magnusbpt/Modbus-wireless/Wireless modbus/Billdere/slave front.jpg

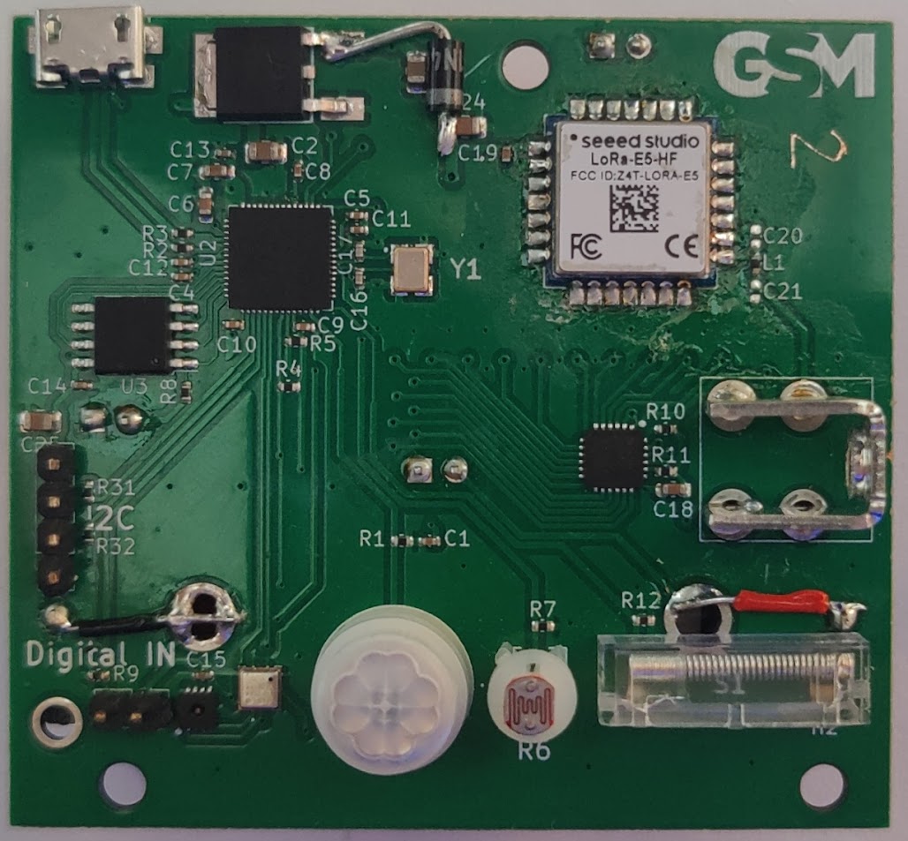
Wireless modbus/Billdere/slave front.jpg
