magnusbpt/Modbus-wireless/Wireless modbus/Billdere/slave back.jpg

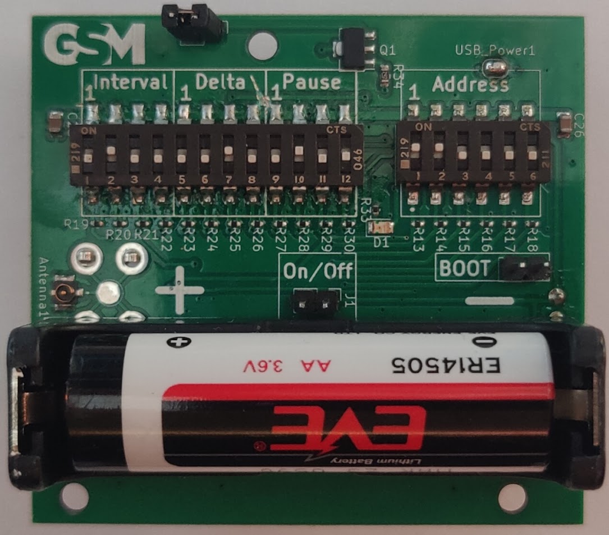
Wireless modbus/Billdere/slave back.jpg
