magnusbpt/Modbus-wireless/Modbus-Master-main/README.md

# GSM-Cloud-Modbus-Master
Repo for working on the GSM Cloud Modbus Master unit.
