magnusbpt/Modbus-wireless/Wireless modbus/Eksamen.pptx

## Lang rækkevidde modbus sensor kommunikation

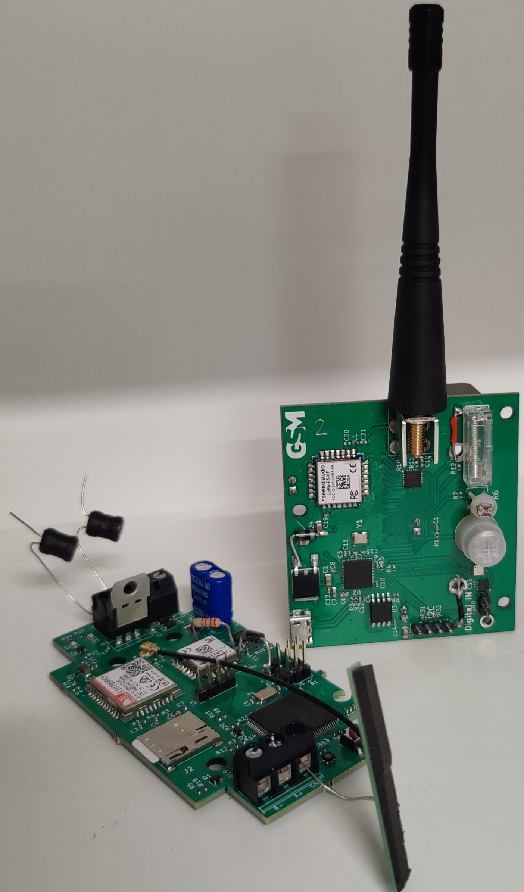
[picture p3: figure]

Afgangsprojekt
Diplomingeniør – Elektronik
Magnus Thurøe & Magnus Tordrup

## Agenda

- Introduktion til projektet
- Test af produkt
- Konklusion af projektet
- Tidsplan

## Introduktion til projektet

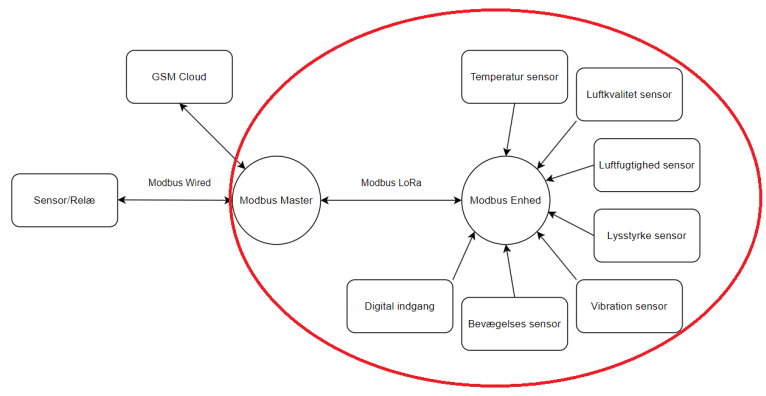
[picture p4: figure]

- GSM teknik ApS
- Forarbejdet
- Trådløs miljøovervågningssystem

## Test af produkt

- Test setup
- Forbindelse mellem enheder
- Eksempel på kommunikation

08600160457946040201000701000100e80201000201d302010003e66e0201000424460201000500000101000600010101000700000157ac

CRC

Slave ID

Adresse 1

Temp data

Data type

Lysstyrke

Luftkvalitet

Digital IN

Bevægelse

Vibration

IMEI nummer

Transaktions ID

Data kommando

Antal Sensore

Luftfugtighed

## Konklusion af projektet

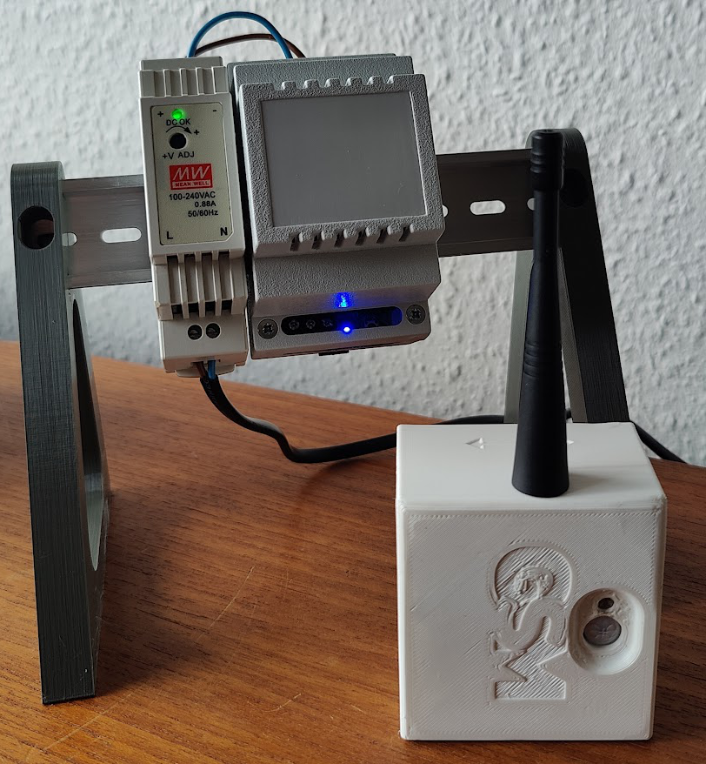
[picture p5: figure]

- Kommunikation
- Sensorer
- Batteri
- EMC

Notes: Kommunikation:
virker 98%, antenne matching
Besked optimering
ID check skal laves om

Senorer:
Vibration = burde laves til Intrup, skal optimeres
LUX = skal kalibreres
AIR = virker ikke, kræver mere tid, men burde virke

Batteri:
Layout ændringer
Laves kode så den faktisk kommer i sleep

EMC:

## Tidsplan

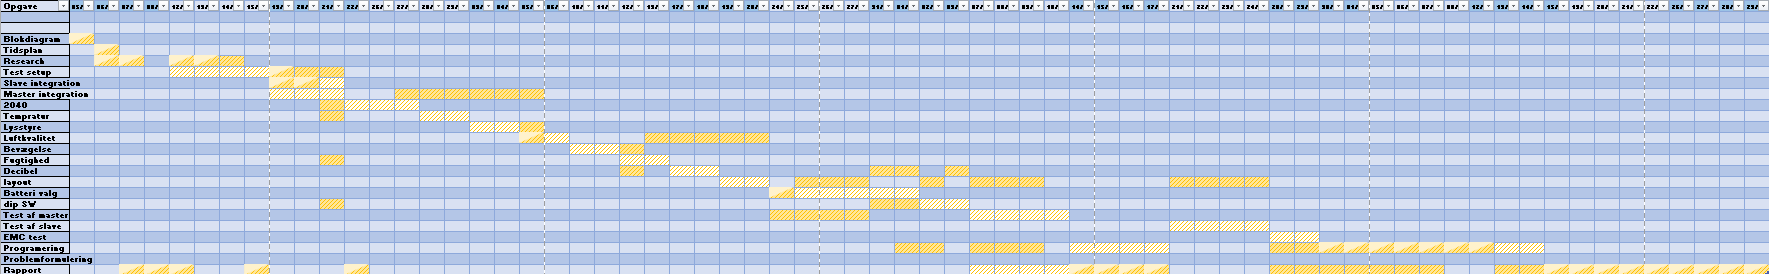
[picture p6: figure]
