magnusbpt/Modbus-wireless/EN 55011 Voltage Mains Class B  (LISN) master 0V.pdf

### EN 55011 Voltage Mains Class B

(LISN)_Test | Passed

# Conducted emission Master 0V

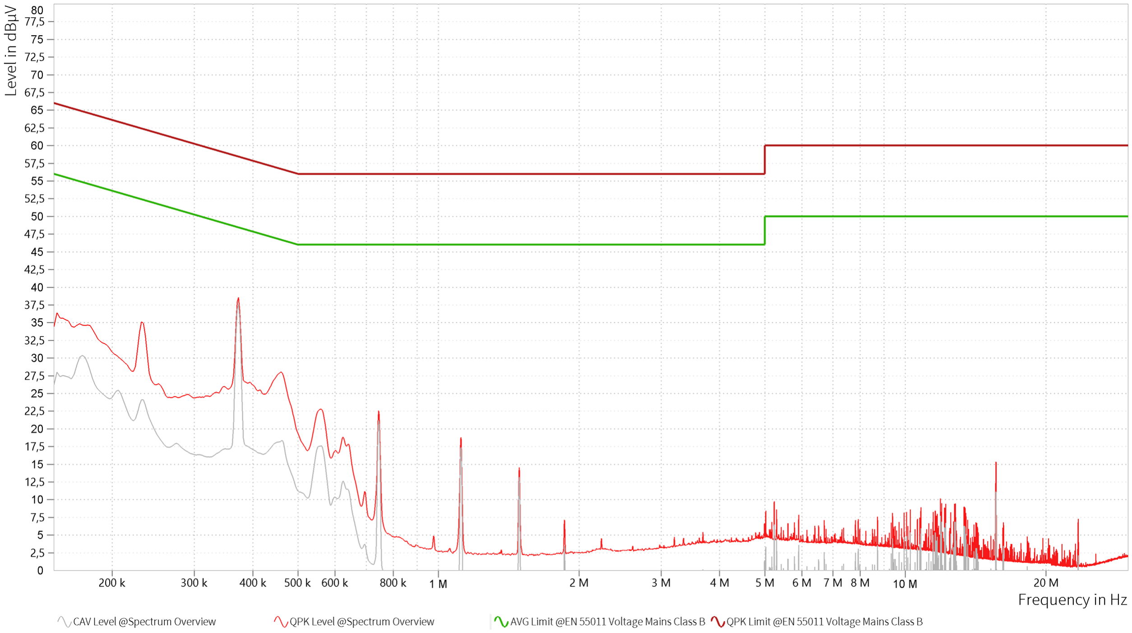
[picture p7: figure]

# EMI Final Results

Frequency; [MHz]; QPK Level [dBµV]; QPK Limit [dBµV]; QPK Margin [dB]; CAV Level [dBµV]; CAV: AVG Limit [dBµV]; CAV Margin [dB]; Correction; Line; Meas. BW [kHz]; Meas. Time [ms]; Time of Meas.; Source; Comment

08-12-2023 / 10:08 | 1 / 1
