magnusbpt/Modbus-wireless/Wireless modbus/Billdere/Adresse_S.png

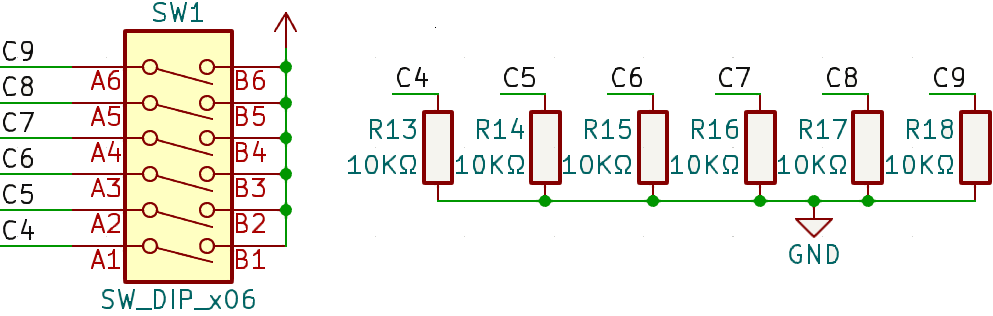
Wireless modbus/Billdere/Adresse_S.png
