magnusbpt/Modbus-wireless/Wireless modbus/Billdere/Air_qua.jpg

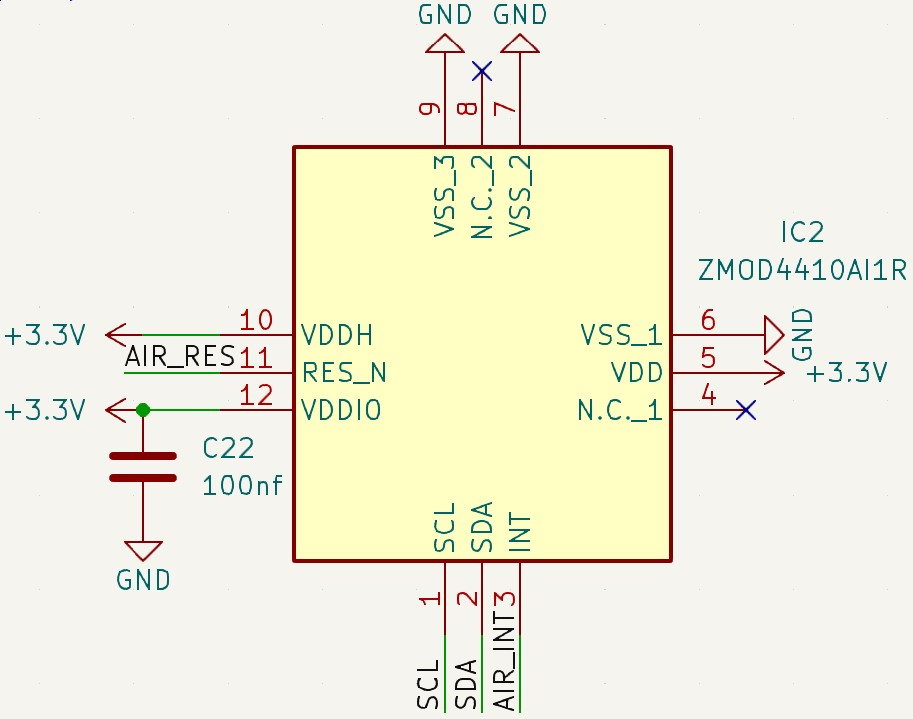
Wireless modbus/Billdere/Air_qua.jpg
