magnusbpt/Modbus-wireless/Wireless modbus/Billdere/Digital_in.jpg

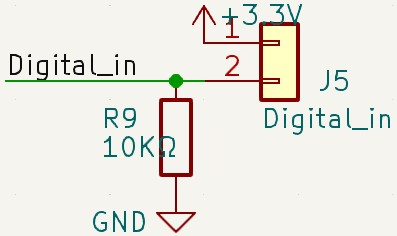
Wireless modbus/Billdere/Digital_in.jpg
