magnusbpt/Modbus-wireless/Wireless modbus/Billdere/Flash.jpg

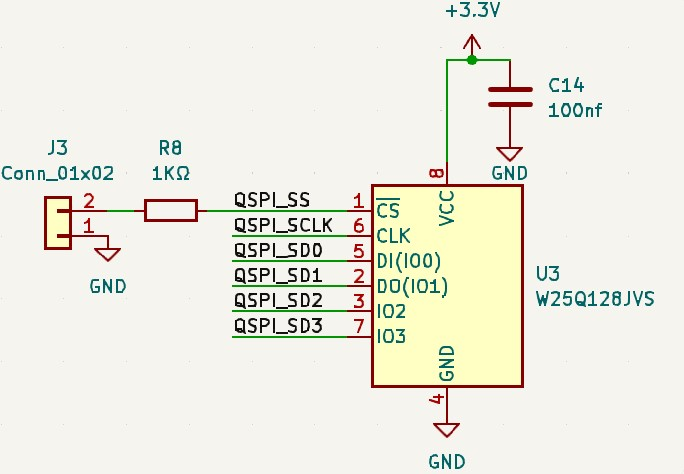
Wireless modbus/Billdere/Flash.jpg
