magnusbpt/Modbus-wireless/Wireless modbus/Billdere/Konfiguration bits.jpg

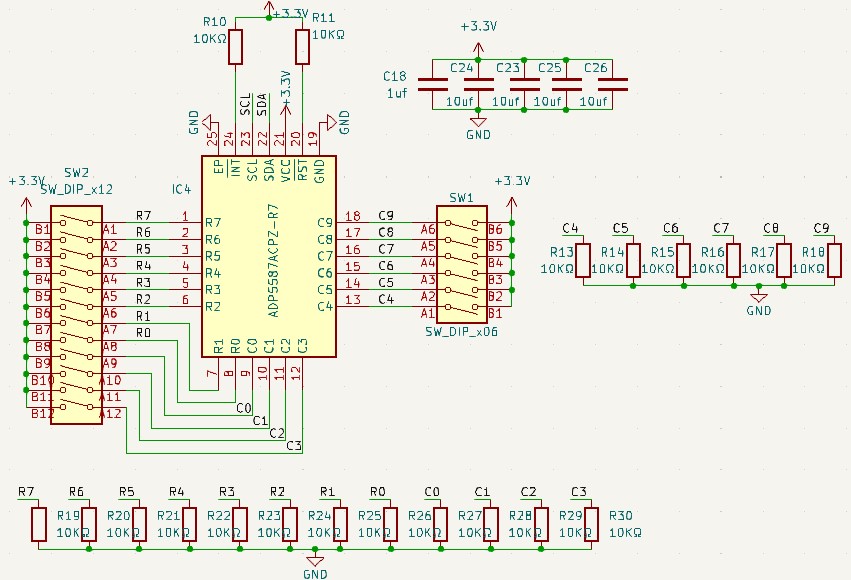
Wireless modbus/Billdere/Konfiguration bits.jpg
