magnusbpt/Modbus-wireless/Wireless modbus/Billdere/LUX.jpg

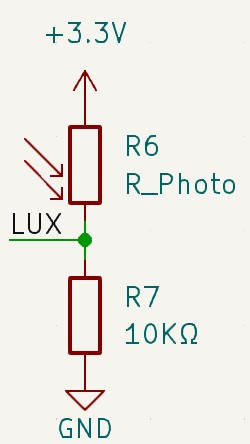
Wireless modbus/Billdere/LUX.jpg
