magnusbpt/Modbus-wireless/Wireless modbus/Billdere/PIR.jpg

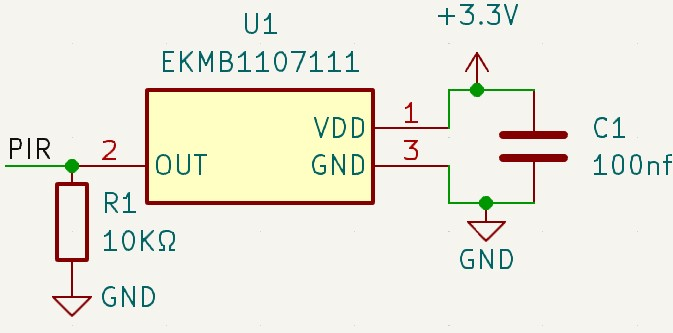
Wireless modbus/Billdere/PIR.jpg
