magnusbpt/Modbus-wireless/Wireless modbus/Billdere/Power.jpg

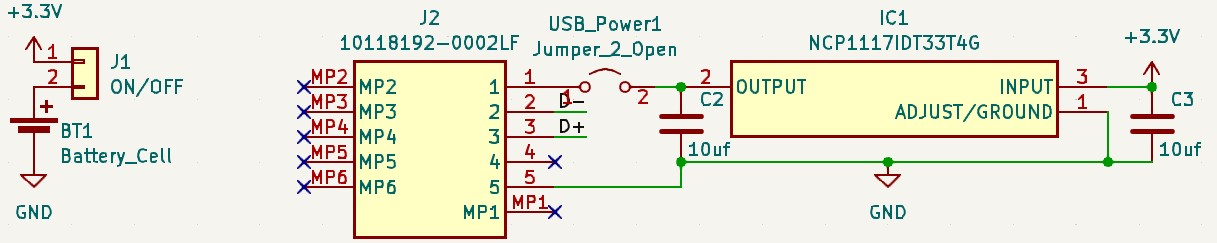
Wireless modbus/Billdere/Power.jpg
