magnusbpt/Modbus-wireless/Wireless modbus/Billdere/RP2040.jpg

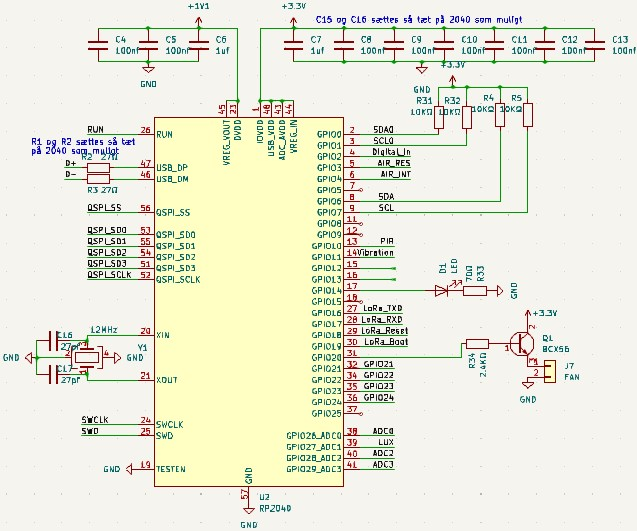
Wireless modbus/Billdere/RP2040.jpg
