magnusbpt/Modbus-wireless/Wireless modbus/Billdere/schematik slave.jpg

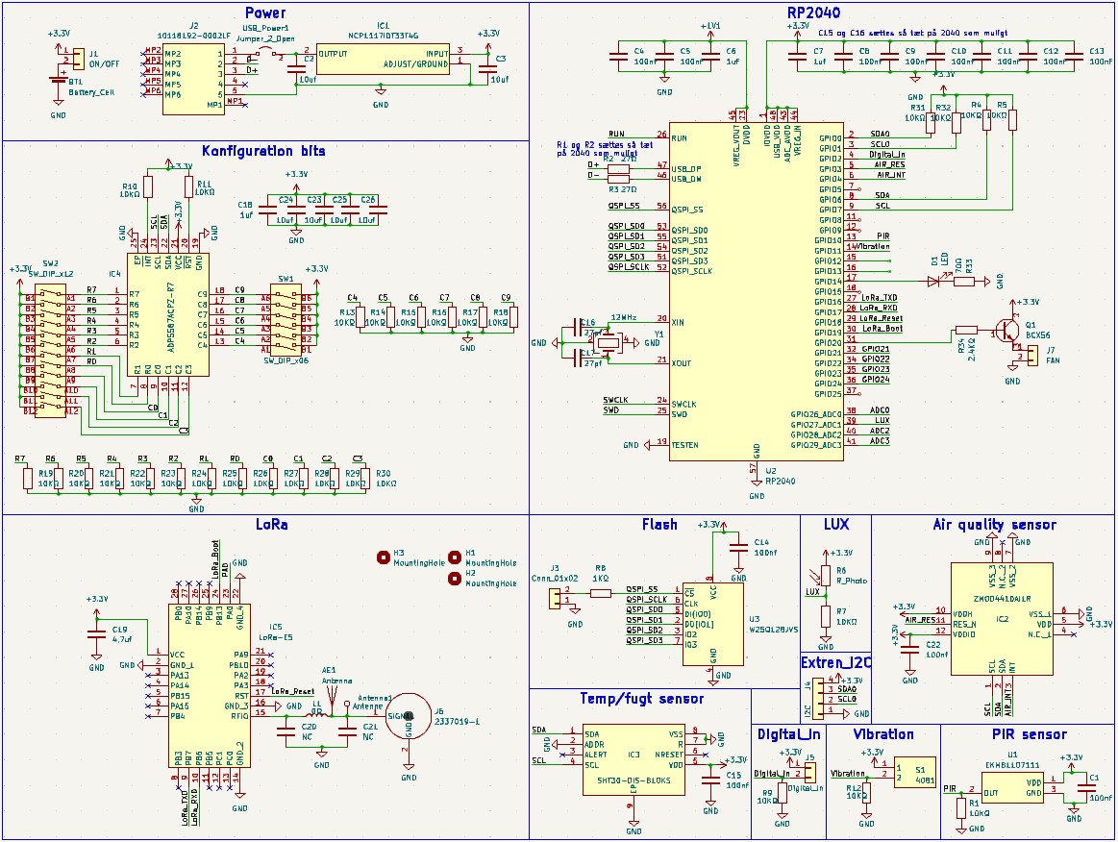
Wireless modbus/Billdere/schematik slave.jpg
