magnusbpt/Modbus-wireless/Wireless modbus/Billdere/Slave 3D back.jpg

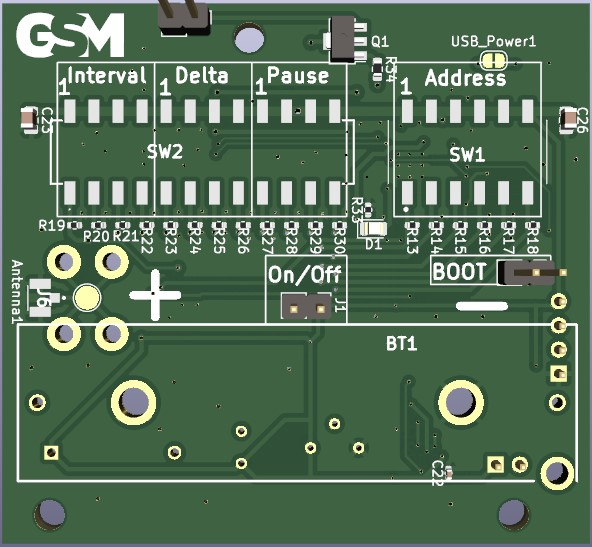
Wireless modbus/Billdere/Slave 3D back.jpg
