magnusbpt/Modbus-wireless/Wireless modbus/Billdere/Slave 3D front.jpg

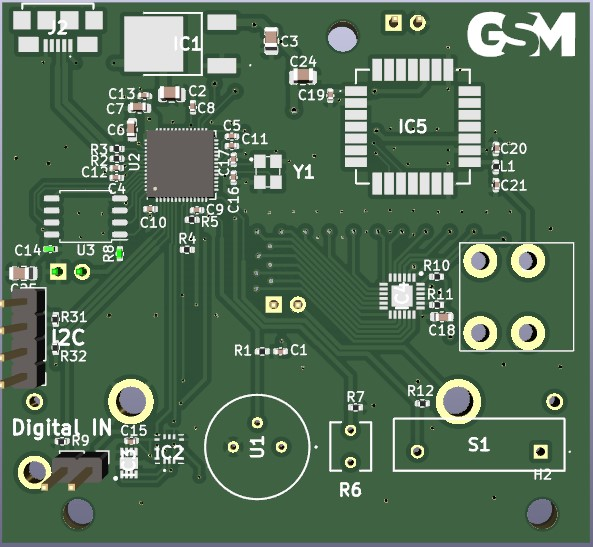
Wireless modbus/Billdere/Slave 3D front.jpg
