magnusbpt/Modbus-wireless/Wireless modbus/Billdere/Temp.jpg

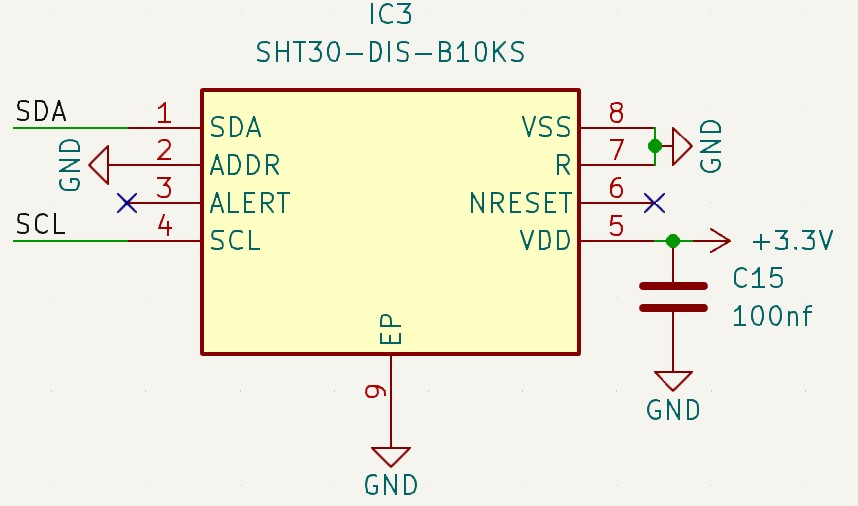
Wireless modbus/Billdere/Temp.jpg
