magnusbpt/Modbus-wireless/Wireless modbus/Billdere/Vibration.jpg

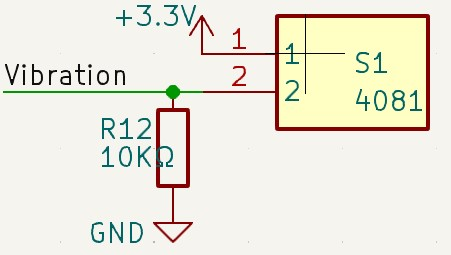
Wireless modbus/Billdere/Vibration.jpg
