magnusbpt/Modbus-wireless/Wireless modbus/Produktion/JLC doc/Modbus master BOM JLC.xlsx

Comment | Designator | Footprint | JLCPCB Part #
33pF | C1-5 | Capacitor_SMD:C_0402_1005Metric | C526997
100nF | C6-9, C11, C12, C14 | Capacitor_SMD:C_0402_1005Metric | C56392
330nF | C10 | Capacitor_SMD:C_0805_2012Metric | C161258
1uF | C15 | Capacitor_SMD:C_0402_1005Metric | C326568
100uF | C16 | Capacitor_SMD:C_1206_3216Metric | C76661
4.7uF | C17 | Capacitor_SMD:C_0402_1005Metric | C2858031
ESDA6V1-5W6 | D1 | SELF_MADE:SOT323-6L | C87908
NH-B2020RGBA-HF | D2 | NHB2020RGBAHF | C2874116
GREEN LED | D3 | LED_SMD:LED_0603_1608Metric | C965805
SS0540_R1_00001 | D4, D5, D8 | Diode_SMD:D_SOD-123 | C282388
GS1M-LTP | D6 | Diode_SMD:D_SMA | C435833
YELLOW LED | D7 | LED_SMD:LED_0603_1608Metric | C965802
DF2S6.8FS,L3M | D9 | Diode_SMD:D_SOD-923 | C1972978
SIM8066-6-1-14-01-A | J2 | SIM8066611401A:SIM8066611401A | C381071
Conn_Coaxial | J4 | Connector_Coaxial:U.FL_Hirose_U.FL-R-SMT-1_Vertical | C434808
0R | L1 | Resistor_SMD:R_0402_1005Metric | C881335
BC847CW | Q1, Q2 | Package_TO_SOT_SMD:SOT-323_SC-70 | C75567
10K | R1, R5-9, R11-14, R18, R19, R21, R26, R27, R29, R30 | Resistor_SMD:R_0402_1005Metric | C25744
22 | R2-4 | Resistor_SMD:R_0402_1005Metric | C25092
47k | R10 | Resistor_SMD:R_0402_1005Metric | C25792
680 | R15 | Resistor_SMD:R_0402_1005Metric | C25113
910 | R16, R17 | Resistor_SMD:R_0402_1005Metric | C44933
20K | R20 | Resistor_SMD:R_0402_1005Metric | C25765
1K | R22, R23, R25 | Resistor_SMD:R_0402_1005Metric | C11702
62 | R24 | Resistor_SMD:R_0805_2012Metric | C560547
200K | R28 | Resistor_SMD:R_0402_1005Metric | C25764
TL3305AF260QG | SW1 | SELF_MADE:TL3305AF260QG | C2886902
ATmega2560-16A | U1 | Package_QFP:TQFP-100_14x14mm_P0.5mm | C22460
SP485EN-L/TR | U2 | Package_SO:SOIC-8_3.9x4.9mm_P1.27mm | C6855
SIM7080G | U4 | SIM7080G:XCVR_SIM7080G | C2943992
LSF0204PW-Q100J | U5 | Package_SO:TSSOP-14_4.4x5mm_P0.65mm | C202288
ABM3B-8.000MHZ-10-1-U-T | Y1 | SELF_MADE:Oscillator_SMD_abm3b | C276420
