magnusbpt/Modbus-wireless/Wireless modbus/Wireless slave/wireless_Slave/JLC/JLCPCB_BOM.xls

Comment | Designator | Footprint | JLCPCB Part#(optional)
C1, C4, C5, C8-15, C22 | 100nf | Capacitor_SMD:C_0402_1005Metric | C1525
C2, C3, C23-26 | 10uf | Capacitor_SMD:C_0805_2012Metric | C15850
C6, C7, C18 | 1uf | Capacitor_SMD:C_0603_1608Metric | C1592
C16, C17 | 27pf | Capacitor_SMD:C_0402_1005Metric | C1557
C19 | 4,7uf | Capacitor_SMD:C_0402_1005Metric | C368809
D1 | LED | LED_SMD:LED_0805_2012Metric | C598370
IC1 | NCP1117IDT33T4G | NCP1117IDT33T4G | C2902115
IC2 | ZMOD4410AI1R | ZMOD4410AI1R | C5342493
IC3 | SHT30-DIS-B10KS | SON50P250X250X100-9N-D | C2687423
IC4 | ADP5587ACPZ-R7 | QFN50P400X400X80-25N-D | C579262
J2 | 10118192-0002LF | 101181920002LF | C2972784
J6 | 2337019-1 | 23370191 | C434807
L1 | 0Ω | Resistor_SMD:R_0402_1005Metric | C881335
Q1 | BCX56 | Package_TO_SOT_SMD:SOT-89-3 | C5345980
R1, R4, R5, R7, R9-32 | 10KΩ | Resistor_SMD:R_0402_1005Metric | C25744
R2, R3 | 27Ω | Resistor_SMD:R_0402_1005Metric | C25100
R8 | 1KΩ | Resistor_SMD:R_0402_1005Metric | C11702
R33 | 70Ω | Resistor_SMD:R_0402_1005Metric | C25133
R34 | 2.4KΩ | Resistor_SMD:R_0603_1608Metric | C22940
SW1 | SW_DIP_x06 | SamacSys_Parts3:2196LPST | C2842671
SW2 | SW_DIP_x12 | SamacSys_Parts3:21912LPST
U2 | RP2040 | Package_DFN_QFN:QFN-56-1EP_7x7mm_P0.4mm_EP3.2x3.2mm | C2040
U3 | W25Q128JVS | Package_SO:SOIC-8_5.23x5.23mm_P1.27mm | C97521
Y1 | 12MHz | SamacSys_Parts2:X322512MSB4SI | C9002
