magnusbpt/Modbus-wireless/Wireless modbus/Wireless slave/3D/bund.stl

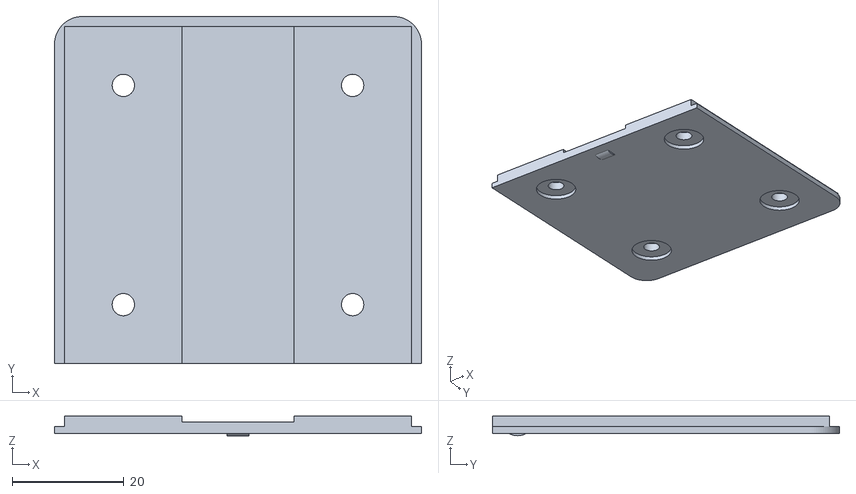
[picture p22: CAD file, 2024-01-15]
Wireless modbus/Wireless slave/3D/bund.stl
65.8 x 62.2 x 3.50
