magnusbpt/Modbus-wireless/Wireless modbus/Wireless slave/3D/slave.stl

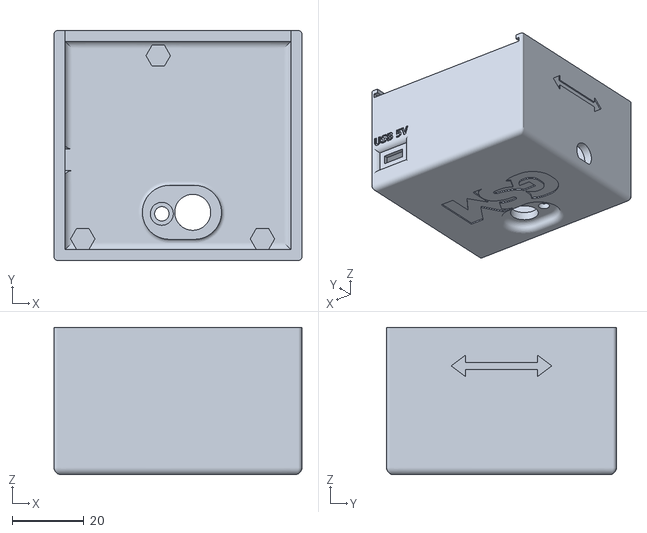
[picture p23: CAD file, 2024-01-15]
Wireless modbus/Wireless slave/3D/slave.stl
69.0 x 64.0 x 41.0
