magnusbpt/Modbus-wireless/(list of files, cad)

Other CAD files:
Wireless modbus/Wireless slave/3D/OldVersions/TOP.0001.ipt
Wireless modbus/Wireless slave/3D/OldVersions/bund.0003.ipt
Wireless modbus/Wireless slave/3D/OldVersions/slave.0003.ipt
Wireless modbus/Wireless slave/3D/SlaveLåg.ipt
Wireless modbus/Wireless slave/3D/TOP.ipt
Wireless modbus/Wireless slave/3D/bund.ipt
Wireless modbus/Wireless slave/3D/slave.ipt
Wireless modbus/Wireless slave/3D/slave2.ipt
