magnusbpt/Modbus-wireless/Modbus-Master-main/Sim7080_test_CAT/Sim7080_test_CAT.txt

=~=~=~=~=~=~=~=~=~=~=~= PuTTY log 2023.02.27 09:12:14 =~=~=~=~=~=~=~=~=~=~=~=
D

+CPIN: NOT READY

OK
AT+CGDCONT=1,"IP","iot.1nce.net"

OK
AT+CFUN=1

OK

+CPIN: READY

SMS Ready

OK
AT+CFUN=0

+CPIN: NOT READY

OK
AT+CGDCONT=1,"IP","iot.1nce.net"

OK
AT+CFUN=1

OK

+CPIN: READY

SMS Ready
Detected: OK
Detected: OK
Detected: OK
Detected: OK
Detected: OK
AT+CMNB=1

OK
-----------------------------Log nr: 1  9:12:10  27.2.2023-----------------------------
Detected: +CEREG: 0,5
-----------------------------time: 9:12:11  27.2.2023-----------------------------
AT+CPIN?

+CPIN: READY

OK
AT+CSQ

+CSQ: 30,99

OK
AT+CFUN=0

+CPIN: NOT READY

OK
AT+CGDCONT=1,"IP","iot.1nce.net"

OK
AT+CFUN=1

OK

+CPIN: READY

SMS Ready
AT+COPS?

+COPS: 0,0,"TeliaDk",7

OK
AT+CGNAPN

+CGNAPN: 1,"iot.1nce.net"

OK
AT+CGATT?

+CGATT: 1

OK
AT+CNACT=0,1

OK

+APP PDP: 0,ACTIVE
AT+CNACT?

+CNACT: 0,1,"10.173.199.220"
+CNACT: 1,0,"0.0.0.0"AT+CAOPEN=0,0,"UDP","164.92.139.57",8080

+CAOPEN: 0,0

OK
AT+CASEND=0,2

> 
OK

+CADATAIND: 0

+CAURC: buffer full,0
AT+CAACK=0

+CAACK: 2,0

OK
AT+CARECV=0,2

+CARECV: 2,00

OK
AT+CACLOSE=0

OK
AT+CNACT=0,0

OK

+APP PDP: 0,DEACTIVE
AT+CPOWD=1

NORMAL POWER DOWN
Detected: OK
Detected: OK
AT+CMNB=1

OK
-----------------------------Log nr: 2  9:20:7  27.2.2023-----------------------------
Detected: +CEREG: 0,5
-----------------------------time: 9:20:7  27.2.2023-----------------------------
AT+CPIN?

+CPIN: READY

OK
AT+CSQ

+CSQ: 23,99

OK
AT+CFUN=0

+CPIN: NOT READY

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
AT+CPIN?

+CPIN: READY

OK
AT+CSQ

+CSQ: 23,99

OK
AT+CFUN=0

+CPIN: NOT READY

OK
AT+CGDCONT=1,"IP","iot.1nce.net"

OK
AT+CFUN=1

OK

+CPIN: READY

SMS Ready
AT+COPS?

+COPS: 0,0,"TeliaDk",7

OK
AT+CGNAPN

+CGNAPN: 1,"iot.1nce.net"

OK
AT+CGATT?

+CGATT: 1

OK
AT+CNACT=0,1

OK

+APP PDP: 0,ACTIVE
AT+CNACT?

+CNACT: 0,1,"10.173.199.220"
+CNACT: 1,0,"0.0.0.0"AT+CAOPEN=0,0,"UDP","164.92.139.57",8080

+CAOPEN: 0,0

OK
AT+CASEND=0,2

> 
OK

+CADATAIND: 0

+CAURC: buffer full,0
AT+CAACK=0

+CAACK: 2,0

OK
AT+CARECV=0,2

+CARECV: 2,00

OK
AT+CACLOSE=0

OK
AT+CNACT=0,0

OK

+APP PDP: 0,DEACTIVE
AT+CPOWD=1
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
