magnusbpt/Modbus-wireless/Radiated Emission test workbenh farraday cage Modbus Master.pdf

### Radiated Emission test workbenh farraday

cage Modbus Master | Failed

# EMI Test Report

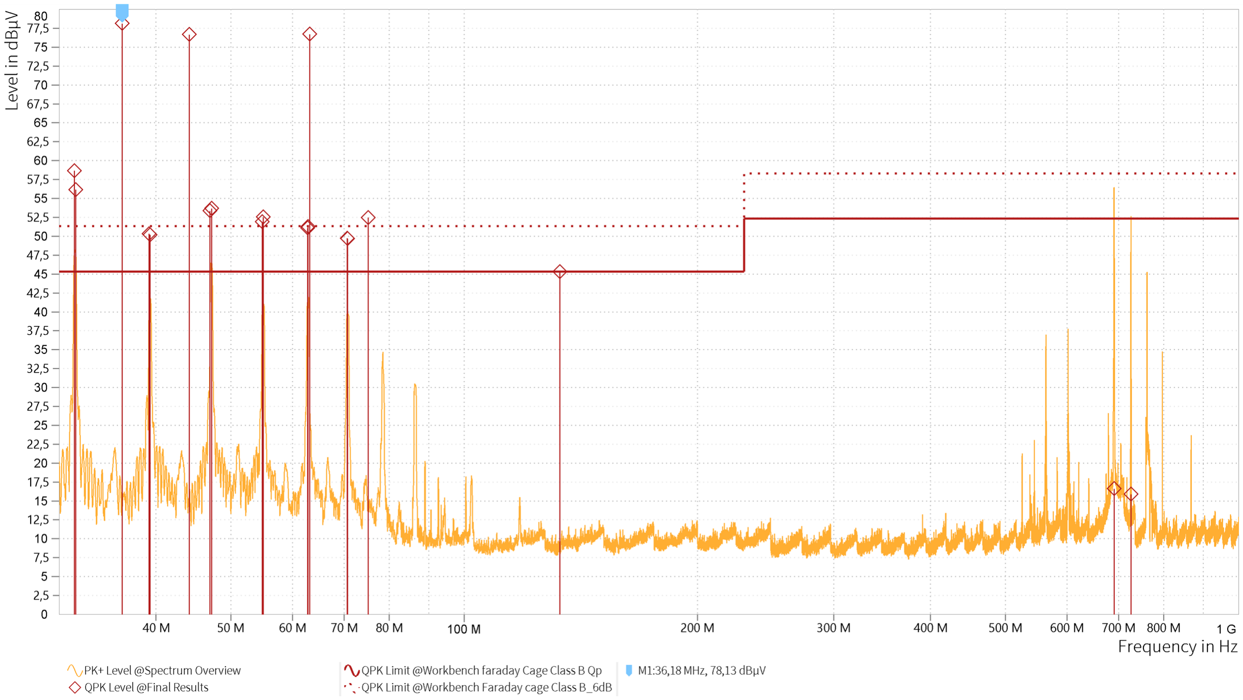
[picture p24: figure]

04-12-2023 / 09:41 | 1 / 3

cage Modbus Master | Failed

# EMI Final Results

Rg | Frequency [MHz] | QPK Level [dBµV] | QPK Limit [dBµV] | QPK Margin [dB] | Correction [dB] | Meas. BW [kHz] | Meas. Time [ms] | Time of Meas. | Source | Comment
1 | 31,380 | 58,67 | 45,30 | -13,37 | 0,00 | 120,000 | 100,000 | 09:28:53 | Critical Points
1 | 31,500 | 56,16 | 45,30 | -10,86 | 0,00 | 120,000 | 100,000 | 09:31:42 | Critical Points
1 | 36,180 | 78,13 | 45,30 | -32,83 | 0,00 | 120,000 | 100,000 | 10:30:02 | Critical Points
1 | 39,180 | 50,32 | 45,30 | -5,02 | 0,00 | 120,000 | 100,000 | 09:28:55 | Critical Points
1 | 39,300 | 50,19 | 45,30 | -4,89 | 0,00 | 120,000 | 100,000 | 09:31:44 | Critical Points
1 | 44,160 | 76,67 | 45,30 | -31,37 | 0,00 | 120,000 | 100,000 | 10:30:05 | Critical Points
1 | 46,980 | 53,36 | 45,30 | -8,06 | 0,00 | 120,000 | 100,000 | 09:28:56 | Critical Points
1 | 47,190 | 53,66 | 45,30 | -8,36 | 0,00 | 120,000 | 100,000 | 09:31:46 | Critical Points
1 | 54,870 | 51,91 | 45,30 | -6,61 | 0,00 | 120,000 | 100,000 | 09:28:58 | Critical Points
1 | 55,050 | 52,54 | 45,30 | -7,24 | 0,00 | 120,000 | 100,000 | 09:31:47 | Critical Points
1 | 62,790 | 51,08 | 45,30 | -5,78 | 0,00 | 120,000 | 100,000 | 09:29:00 | Critical Points
1 | 62,820 | 51,28 | 45,30 | -5,98 | 0,00 | 120,000 | 100,000 | 09:31:49 | Critical Points
1 | 63,180 | 76,70 | 45,30 | -31,40 | 0,00 | 120,000 | 100,000 | 10:30:06 | Critical Points
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
1 | 690,270 | 16,60 | 52,30 | 35,70 | 0,00 | 120,000 | 100,000 | 09:31:53 | Critical Points
1 | 725,790 | 15,89 | 52,30 | 36,41 | 0,00 | 120,000 | 100,000 | 09:31:55 | Critical Points

# Test Information

### Description Test Standard Test Site Operator Name
