magnusbpt/Modbus-wireless/workbench faraday cage 10khz-1ghz_Test Modbus master original conf..pdf

### Workbench faraday cage_Test (1) (2)

(restored) (2) | Inconclusive

# Test Report

### Spectrum Overview

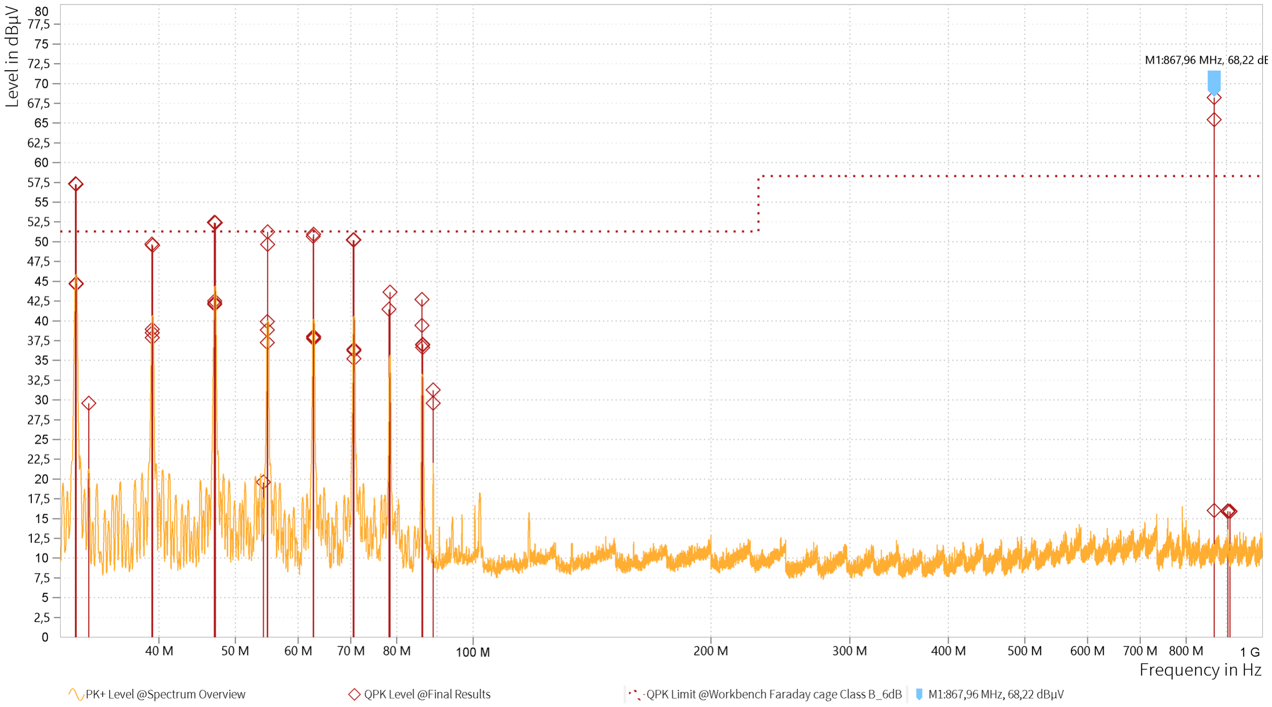
[picture p25: figure]

# EMI Final Results

Rg | Frequency [MHz] | QPK Level [dBµV] | Correction [dB] | Meas. BW [kHz] | Meas. Time [ms] | Time of Meas. | Source | Comment
1 | 31,350 | 57,30 | 0,00 | 120,000 | 100,000 | 10:27:59 | Critical Points
1 | 31,410 | 44,63 | 0,00 | 120,000 | 100,000 | 10:14:30 | Critical Points
1 | 31,410 | 44,71 | 0,00 | 120,000 | 100,000 | 10:17:13 | Critical Points
1 | 31,410 | 44,68 | 0,00 | 120,000 | 100,000 | 10:17:44 | Critical Points
1 | 31,410 | 57,25 | 0,00 | 120,000 | 100,000 | 10:29:01 | Critical Points
1 | 32,580 | 29,57 | 0,00 | 120,000 | 100,000 | 10:29:02 | Critical Points
1 | 39,180 | 49,67 | 0,00 | 120,000 | 100,000 | 10:28:01 | Critical Points
1 | 39,240 | 38,45 | 0,00 | 120,000 | 100,000 | 10:14:32 | Critical Points
1 | 39,240 | 37,87 | 0,00 | 120,000 | 100,000 | 10:17:16 | Critical Points
1 | 39,240 | 38,89 | 0,00 | 120,000 | 100,000 | 10:17:47 | Critical Points
1 | 39,270 | 49,52 | 0,00 | 120,000 | 100,000 | 10:29:04 | Critical Points
1 | 47,010 | 52,42 | 0,00 | 120,000 | 100,000 | 10:28:03 | Critical Points
1 | 47,070 | 42,26 | 0,00 | 120,000 | 100,000 | 10:14:33 | Critical Points
1 | 47,070 | 42,08 | 0,00 | 120,000 | 100,000 | 10:17:18 | Critical Points
1 | 47,070 | 42,49 | 0,00 | 120,000 | 100,000 | 10:17:49 | Critical Points
1 | 47,130 | 52,38 | 0,00 | 120,000 | 100,000 | 10:29:06 | Critical Points
1 | 54,270 | 19,57 | 0,00 | 120,000 | 100,000 | 10:28:05 | Critical Points
04-12-2023 / 10:31 | 1 / 2

### Workbench faraday cage_Test (1) (2)

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
1 | 908,790 | 15,88 | 0,00 | 120,000 | 100,000 | 10:17:31 | Critical Points
1 | 908,790 | 15,90 | 0,00 | 120,000 | 100,000 | 10:18:02 | Critical Points

# Test Information

### Description Test Standard Test Site Operator Name

04-12-2023 / 10:31 | 2 / 2
