magnusbpt/Modbus-wireless/workbench faraday cage 10khz-1ghz_Test Modbus master with 2x1mH in series wih supply.pdf

workbench faraday cage 10khz-1ghz_Test | Inconclusive

# Test Report

### Spectrum Overview

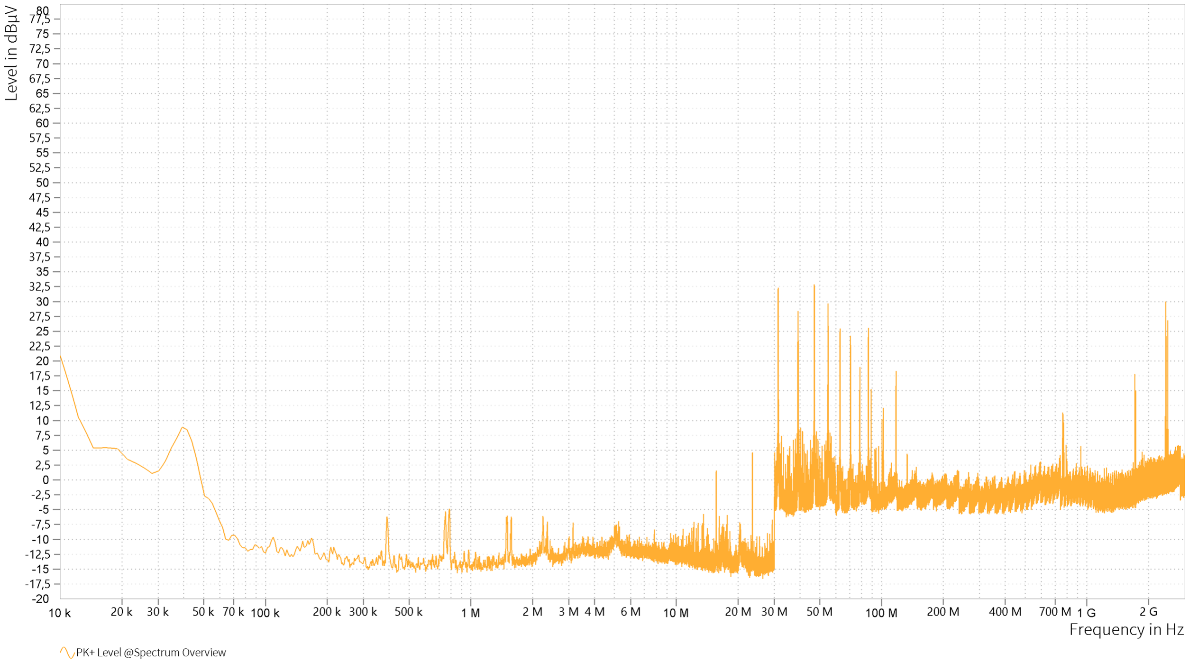
[picture p26: figure]

# EMI Final Results

Rg | Frequency [MHz] | QPK Level [dBµV] | Correction [dB] | Meas. BW [kHz] | Meas. Time [ms] | Time of Meas. | Source | Comment
1 | 0,010 | 68,41 | 0,00 | 9,000 | 100,000 | 09:48:19 | Critical Points
1 | 0,010 | 69,50 | 0,00 | 9,000 | 100,000 | 09:52:57 | Critical Points
1 | 0,010 | 30,44 | 0,00 | 9,000 | 100,000 | 10:01:54 | Critical Points
1 | 0,010 | 29,86 | 0,00 | 9,000 | 100,000 | 10:05:55 | Critical Points
1 | 0,010 | 30,58 | 0,00 | 9,000 | 100,000 | 10:12:15 | Critical Points
1 | 0,017 | 72,70 | 0,00 | 9,000 | 100,000 | 09:53:00 | Critical Points
1 | 0,017 | 16,04 | 0,00 | 9,000 | 100,000 | 10:01:56 | Critical Points
1 | 0,017 | 19,35 | 0,00 | 9,000 | 100,000 | 10:12:17 | Critical Points
1 | 0,019 | 66,72 | 0,00 | 9,000 | 100,000 | 09:48:22 | Critical Points
1 | 0,019 | 17,56 | 0,00 | 9,000 | 100,000 | 10:05:57 | Critical Points
1 | 0,037 | 70,80 | 0,00 | 9,000 | 100,000 | 09:48:25 | Critical Points
1 | 0,037 | 69,45 | 0,00 | 9,000 | 100,000 | 09:53:02 | Critical Points
1 | 0,039 | 17,25 | 0,00 | 9,000 | 100,000 | 10:01:58 | Critical Points
1 | 0,039 | 16,04 | 0,00 | 9,000 | 100,000 | 10:12:19 | Critical Points
1 | 0,042 | 20,34 | 0,00 | 9,000 | 100,000 | 10:05:59 | Critical Points
1 | 0,051 | 56,76 | 0,00 | 9,000 | 100,000 | 09:48:27 | Critical Points
1 | 0,053 | 54,62 | 0,00 | 9,000 | 100,000 | 09:53:03 | Critical Points
04-12-2023 / 10:13 | 1 / 4

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
1 | 2.426,003 | 24,11 | 0,00 | 9,000 | 100,000 | 10:12:48 | Critical Points
1 | 2.426,052 | 26,75 | 0,00 | 9,000 | 100,000 | 10:12:50 | Critical Points
1 | 2.479,917 | 24,45 | 0,00 | 9,000 | 100,000 | 10:12:52 | Critical Points
1 | 2.479,994 | 23,81 | 0,00 | 9,000 | 100,000 | 10:12:54 | Critical Points

# [No Generic Table(s) Selected]

# Test Information

### Description Test Standard Test Site Operator Name
