magnusbpt/Modbus-wireless/workbench faraday cage 10khz-1ghz_Test Modbus slave test original conf. Lora gnd.pdf

Workbench faraday cage_Test (3) (2) | Inconclusive

# Test Report

### Spectrum Overview

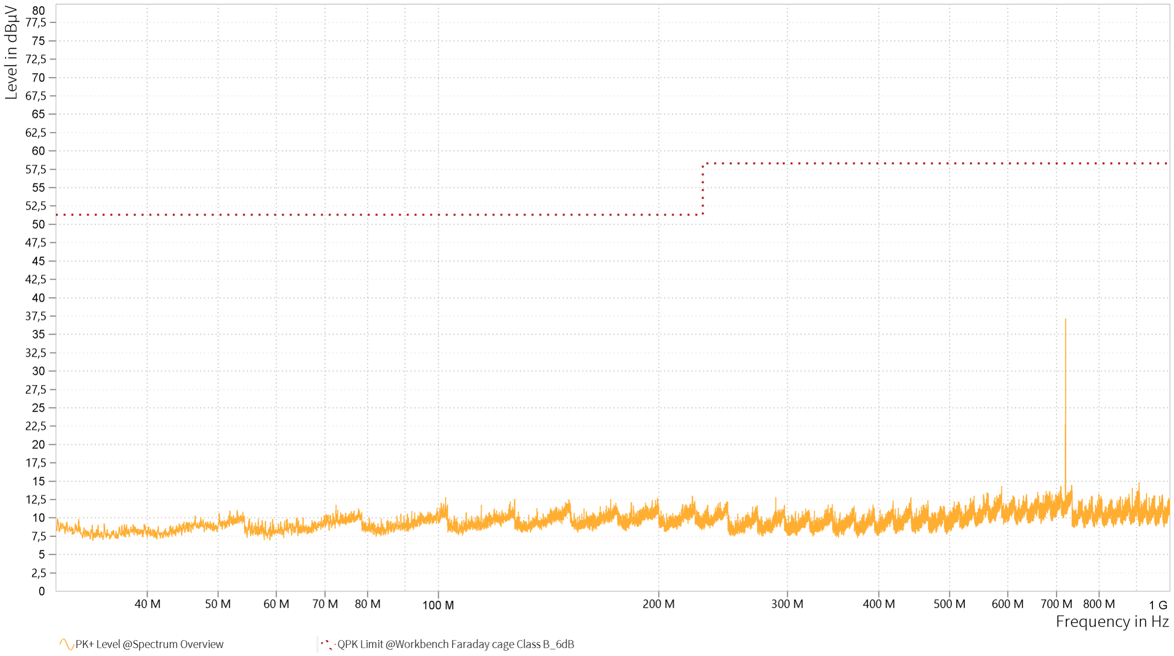
[picture p27: figure]

# EMI Final Results

Rg | Frequency [MHz] | QPK Level [dBµV] | Correction [dB] | Meas. BW [kHz] | Meas. Time [ms] | Time of Meas. | Source | Comment
1 | 38,790 | 33,15 | 0,00 | 120,000 | 100,000 | 10:52:11 | Critical Points
1 | 69,570 | 33,76 | 0,00 | 120,000 | 100,000 | 10:52:13 | Critical Points
1 | 72,630 | 31,12 | 0,00 | 120,000 | 100,000 | 10:52:14 | Critical Points
1 | 77,910 | 28,53 | 0,00 | 120,000 | 100,000 | 10:52:16 | Critical Points
1 | 96,600 | 24,60 | 0,00 | 120,000 | 100,000 | 10:52:17 | Critical Points
1 | 168,000 | 27,96 | 0,00 | 120,000 | 100,000 | 10:52:19 | Critical Points
1 | 661,170 | 23,49 | 0,00 | 120,000 | 100,000 | 10:52:21 | Critical Points
1 | 720,120 | 20,86 | 0,00 | 120,000 | 100,000 | 10:55:32 | Critical Points
1 | 760,620 | 23,60 | 0,00 | 120,000 | 100,000 | 10:52:22 | Critical Points
1 | 791,370 | 26,73 | 0,00 | 120,000 | 100,000 | 10:52:24 | Critical Points
1 | 867,960 | 16,03 | 0,00 | 120,000 | 100,000 | 10:52:26 | Critical Points
1 | 907,770 | 15,87 | 0,00 | 120,000 | 100,000 | 10:55:34 | Critical Points
04-12-2023 / 10:57 | 1 / 1
