magnusbpt/Modbus-wireless/Workbench faraday cage_Test Master 1mH modbus side.pdf

Workbench faraday cage_Test (4) (3) | Inconclusive

# Master modbus side 1mH coils

### Spectrum Overview

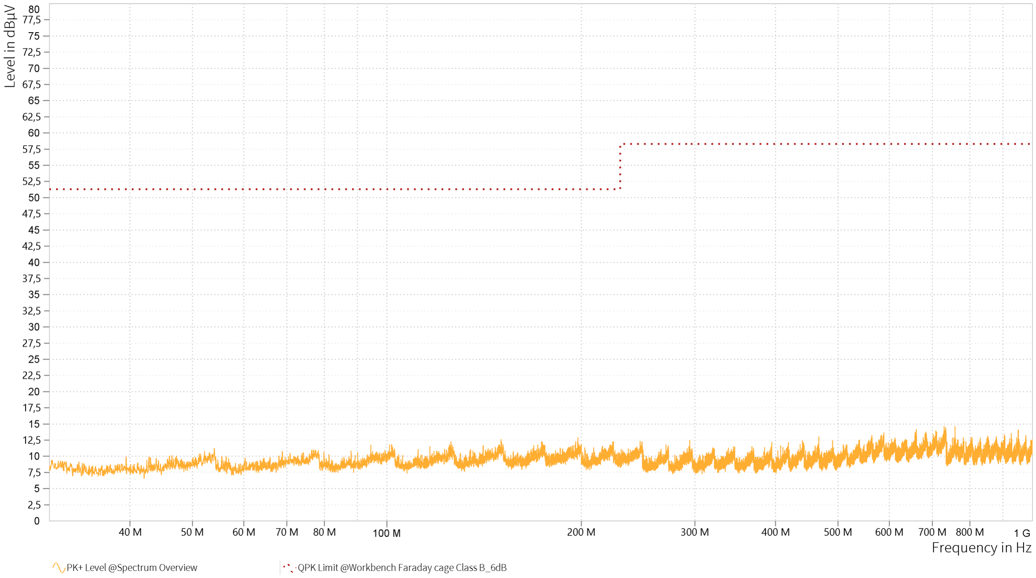
[picture p28: figure]

# EMI Final Results

Rg | Frequency [MHz] | QPK Level [dBµV] | Correction [dB] | Meas. BW [kHz] | Meas. Time [ms] | Time of Meas. | Source | Comment
1 | 31,440 | 45,74 | 0,00 | 120,000 | 100,000 | 10:11:44 | Critical Points
1 | 39,270 | 39,42 | 0,00 | 120,000 | 100,000 | 10:11:46 | Critical Points
1 | 47,160 | 38,98 | 0,00 | 120,000 | 100,000 | 10:11:47 | Critical Points
1 | 54,990 | 37,40 | 0,00 | 120,000 | 100,000 | 10:11:48 | Critical Points
1 | 62,820 | 36,00 | 0,00 | 120,000 | 100,000 | 10:11:50 | Critical Points
1 | 70,650 | 35,02 | 0,00 | 120,000 | 100,000 | 10:11:51 | Critical Points
1 | 78,540 | 29,02 | 0,00 | 120,000 | 100,000 | 10:11:53 | Critical Points
1 | 86,400 | 36,36 | 0,00 | 120,000 | 100,000 | 10:11:54 | Critical Points
1 | 102,120 | 27,34 | 0,00 | 120,000 | 100,000 | 10:11:56 | Critical Points
1 | 117,810 | 28,98 | 0,00 | 120,000 | 100,000 | 10:11:58 | Critical Points
1 | 729,840 | 15,85 | 0,00 | 120,000 | 100,000 | 10:15:09 | Critical Points
1 | 758,550 | 18,06 | 0,00 | 120,000 | 100,000 | 10:15:11 | Critical Points
08-12-2023 / 10:15 | 1 / 1
