magnusbpt/Modbus-wireless/Workbench faraday cage_Test slave pcb gnd battery supply.pdf

### Workbench faraday cage_Test (3) (2)

(restored) | Inconclusive

# Test Report

### Spectrum Overview

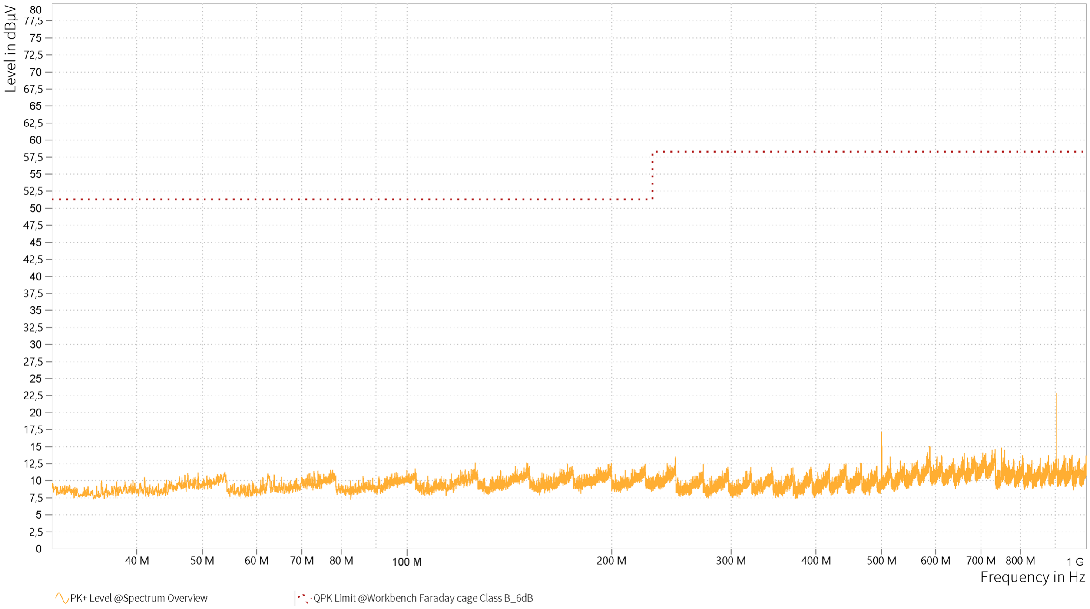
[picture p29: figure]

08-12-2023 / 09:44 | 1 / 2

### Workbench faraday cage_Test (3) (2)

(restored) | Inconclusive

# EMI Final Results

Rg | Frequency [MHz] | QPK Level [dBµV] | Correction [dB] | Meas. BW [kHz] | Meas. Time [ms] | Time of Meas. | Source | Comment
1 | 38,790 | 33,15 | 0,00 | 120,000 | 100,000 | 10:52:11 | Critical Points
1 | 69,570 | 33,76 | 0,00 | 120,000 | 100,000 | 10:52:13 | Critical Points
1 | 72,630 | 31,12 | 0,00 | 120,000 | 100,000 | 10:52:14 | Critical Points
1 | 77,910 | 28,53 | 0,00 | 120,000 | 100,000 | 10:52:16 | Critical Points
1 | 96,600 | 24,60 | 0,00 | 120,000 | 100,000 | 10:52:17 | Critical Points
1 | 168,000 | 27,96 | 0,00 | 120,000 | 100,000 | 10:52:19 | Critical Points
1 | 173,970 | 15,13 | 0,00 | 120,000 | 100,000 | 09:41:23 | Critical Points
1 | 248,430 | 14,46 | 0,00 | 120,000 | 100,000 | 09:43:14 | Critical Points
1 | 500,010 | 26,27 | 0,00 | 120,000 | 100,000 | 09:43:16 | Critical Points
1 | 588,210 | 16,33 | 0,00 | 120,000 | 100,000 | 09:43:18 | Critical Points
1 | 661,170 | 23,49 | 0,00 | 120,000 | 100,000 | 10:52:21 | Critical Points
1 | 720,120 | 20,86 | 0,00 | 120,000 | 100,000 | 10:55:32 | Critical Points
1 | 734,550 | 14,32 | 0,00 | 120,000 | 100,000 | 09:41:25 | Critical Points
1 | 750,000 | 21,34 | 0,00 | 120,000 | 100,000 | 09:43:19 | Critical Points
1 | 760,620 | 23,60 | 0,00 | 120,000 | 100,000 | 10:52:22 | Critical Points
1 | 791,370 | 26,73 | 0,00 | 120,000 | 100,000 | 10:52:24 | Critical Points
1 | 867,960 | 16,03 | 0,00 | 120,000 | 100,000 | 10:52:26 | Critical Points
1 | 904,800 | 16,02 | 0,00 | 120,000 | 100,000 | 09:43:21 | Critical Points
1 | 907,770 | 15,87 | 0,00 | 120,000 | 100,000 | 10:55:34 | Critical Points
08-12-2023 / 09:44 | 2 / 2
