magnusbpt/Modbus-wireless/Workbench faraday cage_Test slave pcb I2C gnd ext. supply.pdf

Workbench faraday cage_Test (4) (2) | Inconclusive

# Slave ext. supply I2C Gnd

### Spectrum Overview

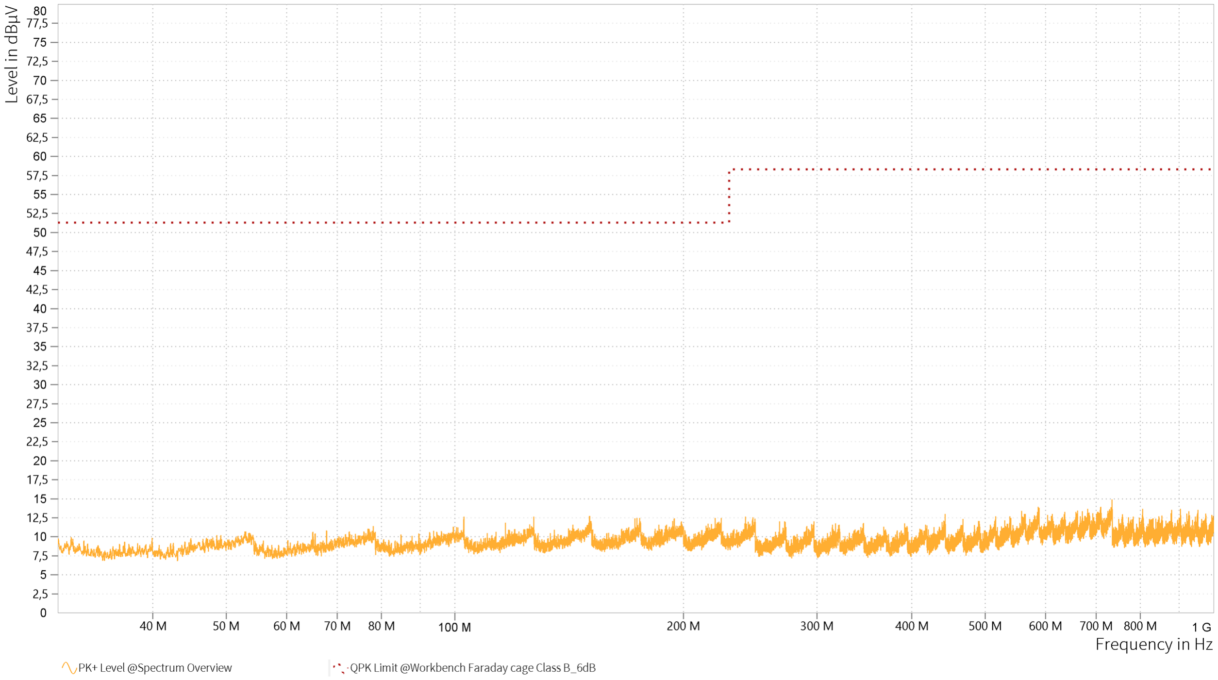
[picture p31: figure]

# EMI Final Results

Rg | Frequency [MHz] | QPK Level [dBµV] | Correction [dB] | Meas. BW [kHz] | Meas. Time [ms] | Time of Meas. | Source | Comment
1 | 100,500 | 19,34 | 0,00 | 120,000 | 100,000 | 09:52:04 | Critical Points
1 | 718,500 | 19,75 | 0,00 | 120,000 | 100,000 | 09:52:05 | Critical Points
1 | 723,000 | 16,93 | 0,00 | 120,000 | 100,000 | 09:52:06 | Critical Points
1 | 732,000 | 35,18 | 0,00 | 120,000 | 100,000 | 09:52:08 | Critical Points
1 | 732,930 | 14,03 | 0,00 | 120,000 | 100,000 | 09:55:28 | Critical Points
1 | 734,250 | 14,15 | 0,00 | 120,000 | 100,000 | 09:56:00 | Critical Points
1 | 758,880 | 16,74 | 0,00 | 120,000 | 100,000 | 09:52:09 | Critical Points
1 | 951,090 | 17,91 | 0,00 | 120,000 | 100,000 | 09:52:10 | Critical Points
08-12-2023 / 09:57 | 1 / 1
