magnusbpt/Modbus-wireless/Modbus-Master-main/Sim7080_altsoft_com/Sim7080_altsoft_com.ino

#include <AltSoftSerial.h>

AltSoftSerial altSerial;

void setup() {
  Serial.begin(9600);
  Serial.println("AltSoftSerial Test Begin");
  altSerial.begin(9600);
}

void loop() {
  char c;

  if (Serial.available()) {
    c = Serial.read();
    altSerial.print(c);
  }
  if (altSerial.available()) {
    c = altSerial.read();
    Serial.print(c);
  }
}
