magnusbpt/Modbus-wireless/Wireless modbus/Programmering/Fugtighed ting/zmod4xxx_evk_example/src/zmod4xxx_types.h

/*******************************************************************************
 * Copyright (c) 2023 Renesas Electronics Corporation
 * All Rights Reserved.
 *
 * This code is proprietary to Renesas, and is license pursuant to the terms and
 * conditions that may be accessed at:
 * https://www.renesas.com/eu/en/document/msc/renesas-software-license-terms-gas-sensor-software
 *
 ******************************************************************************/

/**
 * @file   zmod4xxx_types.h
 * @brief  zmod4xxx types
 * @version 2.6.0
 * @author Renesas Electronics Corporation
 */

#ifndef _ZMOD4XXX_TYPES_H
#define _ZMOD4XXX_TYPES_H

#include <stdint.h>
#include <stdio.h>

/**
 * @brief error_codes Error codes
 */
typedef enum {
    ZMOD4XXX_OK = 0,
    ERROR_INIT_OUT_OF_RANGE =
        -1, /**< The initialization value is out of range. */
    ERROR_GAS_TIMEOUT =
        -2, /**< A previous measurement is running that could not be stopped
                 or sensor does not respond. */
    ERROR_I2C = -3, /**< I2C communication was not successful. */
    ERROR_SENSOR_UNSUPPORTED =
        -4, /**< The Firmware configuration used does not match the sensor
                 module.*/
    ERROR_CONFIG_MISSING =
        -5, /**< There is no pointer to a valid configuration. */
    ERROR_ACCESS_CONFLICT =
        -6, /**< Invalid ADC results due to a still running measurement
                while results readout.*/
    ERROR_POR_EVENT =
        -7, /**< Power-on reset event. Check power supply and reset pin. */
    ERROR_CLEANING =
        -8, /**< The maximum numbers of cleaning cycles ran on this sensor.
                 Cleaning function has no effect anymore. */
    ERROR_NULL_PTR =
        -9 /**< The dev structure did not receive the pointers for I2C read,
                write and/or delay.*/
} zmod4xxx_err;

/**
* @brief   function pointer type for i2c access
* @param   [in] addr 7-bit I2C slave address of the ZMOD4xxx
* @param   [in] reg_addr address of internal register to read/write
* @param   [in,out] data pointer to the read/write data value
* @param   [in] len number of bytes to read/write
* @return  error code
* @retval  0 success
* @retval  "!= 0" error
*/
typedef int8_t (*zmod4xxx_i2c_ptr_t)(uint8_t addr, uint8_t reg_addr,
                                     uint8_t *data_buf, uint8_t len);

/**
 * @brief function pointer to hardware dependent delay function
 * @param [in] delay in milliseconds
 * @return none
 */
typedef void (*zmod4xxx_delay_ptr_p)(uint32_t ms);

/**
 * @brief A single data set for the configuration
 */
typedef struct {
    uint8_t addr;
    uint8_t len;
    uint8_t *data_buf;
} zmod4xxx_conf_str;

/**
 * @brief Structure to hold the gas sensor module configuration.
 */
typedef struct {
    uint8_t start;
    zmod4xxx_conf_str h;
    zmod4xxx_conf_str d;
    zmod4xxx_conf_str m;
    zmod4xxx_conf_str s;
    zmod4xxx_conf_str r;
    uint8_t prod_data_len;
} zmod4xxx_conf;

/**
 * @brief Device structure ZMOD4xxx
 */
typedef struct {
    uint8_t i2c_addr; /**< i2c address of the sensor */
    uint8_t config[6]; /**< configuration parameter set */
    uint16_t mox_er; /**< sensor specific parameter */
    uint16_t mox_lr; /**< sensor specific parameter */
    uint16_t pid; /**< product id of the sensor */
    uint8_t *prod_data; /**< production data */
    zmod4xxx_i2c_ptr_t read; /**< function pointer to i2c read */
    zmod4xxx_i2c_ptr_t write; /**< function pointer to i2c write */
    zmod4xxx_delay_ptr_p delay_ms; /**< function pointer to delay function */
    zmod4xxx_conf *init_conf; /**< pointer to the init configuration */
    zmod4xxx_conf *meas_conf; /**< pointer to the measurement configuration */
} zmod4xxx_dev_t;


#endif // _ZMOD4XXX_TYPES_H
