magnusbpt/Modbus-wireless/(commit log)

2023-09-08 Tilføjet modbus master
    [Modbus master BOM v2 (1).xlsx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]
2023-09-08 Ændring
    [Modbus master BOM v2 (1).xlsx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]
2023-09-08 slave oprette
    [wireless_Slave.kicad_pcb, wireless_Slave.kicad_sch]
2023-09-08 ændringer
    [wireless_Slave.kicad_sch]
2023-09-20 ny tidsplan
    [Tidsplan.xlsx, tidsplan_Modbus.xlsx]
2023-10-03 Ændring i print
    [Modbus_master.kicad_pcb, Modbus_master.kicad_sch]
2023-10-19 wup wup
    [LoRa_sch.kicad_sch, RPI2040_main_sch.kicad_sch, Tidsplan.xlsx, dB_sensor.kicad_sch, wireless_Slave.kicad_pcb]
2023-10-31 Tilføj kicad ting
2023-11-17 håhå
    [RPI2040_main_sch.kicad_sch]
